urish/tt07-charge-pump/sim/freq_voltage_plot.png

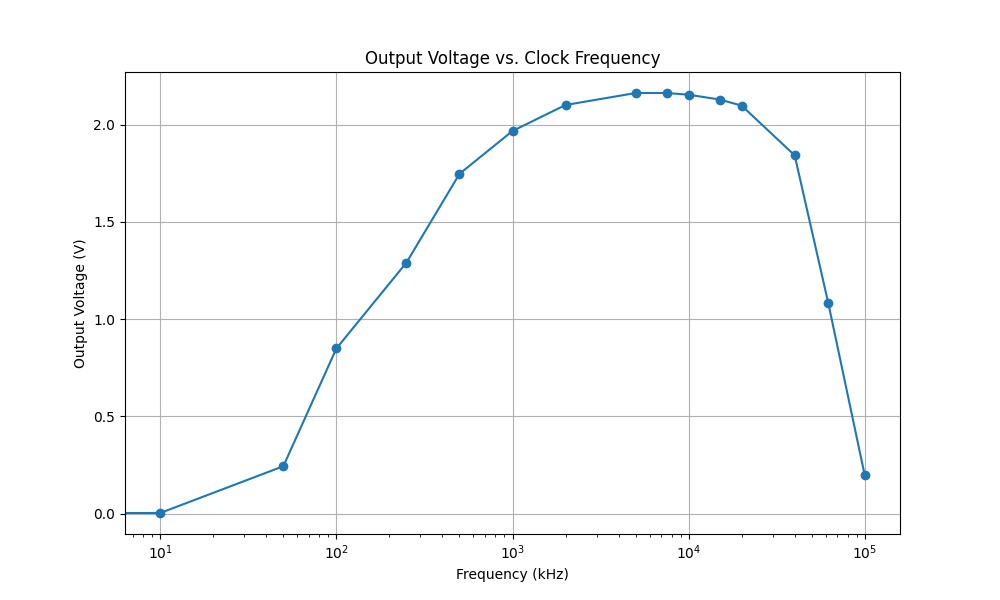
sim/freq_voltage_plot.png
