urish/tt07-charge-pump/sim/tt_um_urish_charge_pump.spice

* NGSPICE file created from tt_um_urish_charge_pump.ext - technology: sky130A

.subckt tt_um_urish_charge_pump clk ena rst_n ua[0] ua[1] ua[2] ua[3] ua[4] ua[5]
+ ua[6] ua[7] ui_in[0] ui_in[1] ui_in[2] ui_in[3] ui_in[4] ui_in[5] ui_in[6] ui_in[7]
+ uio_in[0] uio_in[1] uio_in[2] uio_in[3] uio_in[4] uio_in[5] uio_in[6] uio_in[7]
+ uio_oe[0] uio_oe[1] uio_oe[2] uio_oe[3] uio_oe[4] uio_oe[5] uio_oe[6] uio_oe[7]
+ uio_out[0] uio_out[1] uio_out[2] uio_out[3] uio_out[4] uio_out[5] uio_out[6] uio_out[7]
+ uo_out[0] uo_out[1] uo_out[2] uo_out[3] uo_out[4] uo_out[5] uo_out[6] uo_out[7]
+ VPWR VGND
X0 clka clk.t0 VGND.t2 VGND.t0 sky130_fd_pr__nfet_01v8 ad=0.29 pd=2.58 as=0.29 ps=2.58 w=1 l=0.45
X1 stage2.t4 clkb.t0 sky130_fd_pr__cap_mim_m3_1 l=25 w=25
X2 ua[0].t3 VGND.t3 VGND.t4 ua[0].t2 sky130_fd_pr__pfet_g5v0d10v5 ad=0.1218 pd=1.42 as=0.1218 ps=1.42 w=0.42 l=40
X3 stage3.t0 stage2.t0 stage2.t2 stage2.t1 sky130_fd_pr__nfet_01v8_lvt ad=2.03 pd=14.58 as=2.03 ps=14.58 w=7 l=8
X4 VGND.t5 vout sky130_fd_pr__cap_mim_m3_1 l=25 w=30
X5 stage3.t4 clka.t1 sky130_fd_pr__cap_mim_m3_1 l=25 w=25
X6 clkb.t2 clka VGND.t1 VGND.t0 sky130_fd_pr__nfet_01v8 ad=0.29 pd=2.58 as=0.29 ps=2.58 w=1 l=0.45
X7 VPWR.t2 clk.t1 clka VPWR.t0 sky130_fd_pr__pfet_01v8 ad=0.435 pd=3.58 as=0.435 ps=3.58 w=1.5 l=0.45
X8 ua[0].t1 ua[0].t0 vout.t1 vout.t0 sky130_fd_pr__pfet_g5v0d10v5 ad=0.1218 pd=1.42 as=0.1218 ps=1.42 w=0.42 l=40
X9 stage3.t3 stage3.t1 vout stage3.t2 sky130_fd_pr__nfet_01v8_lvt ad=2.03 pd=14.58 as=2.03 ps=14.58 w=7 l=8
X10 stage2.t3 stage1.t0 stage1.t2 stage1.t1 sky130_fd_pr__nfet_01v8_lvt ad=2.03 pd=14.58 as=2.03 ps=14.58 w=7 l=8
X11 stage1.t3 VPWR.t3 VPWR.t5 VPWR.t4 sky130_fd_pr__nfet_01v8_lvt ad=2.03 pd=14.58 as=2.03 ps=14.58 w=7 l=8
X12 stage1.t4 clka.t0 sky130_fd_pr__cap_mim_m3_1 l=25 w=25
X13 VPWR.t1 clka.t2 clkb.t1 VPWR.t0 sky130_fd_pr__pfet_01v8 ad=0.435 pd=3.58 as=0.435 ps=3.58 w=1.5 l=0.45
R0 clk.n0 clk.t1 276.433
R1 clk.n0 clk.t0 244.831
R2 clk clk.n0 12.3379
R3 VGND.n7 VGND.n3 2479.88
R4 VGND.n7 VGND.n4 2479.88
R5 VGND.n19 VGND.n3 2479.88
R6 VGND.n19 VGND.n4 2479.88
R7 VGND.n18 VGND.n12 2479.88
R8 VGND.n12 VGND.n8 2479.88
R9 VGND.n10 VGND.n8 2479.88
R10 VGND.n18 VGND.n10 2479.88
R11 VGND.n51 VGND.t4 660.787
R12 VGND.n9 VGND.n5 403.712
R13 VGND.n11 VGND.n5 403.712
R14 VGND.n20 VGND.n19 195
R15 VGND.n19 VGND.t0 195
R16 VGND.n7 VGND.n6 195
R17 VGND.t0 VGND.n7 195
R18 VGND.n18 VGND.n17 195
R19 VGND.t0 VGND.n18 195
R20 VGND.n14 VGND.n8 195
R21 VGND.t0 VGND.n8 195
R22 VGND.n6 VGND.n2 161.13
R23 VGND.n6 VGND.n1 161.13
R24 VGND.n20 VGND.n2 161.13
R25 VGND.n17 VGND.n13 161.13
R26 VGND.n14 VGND.n13 161.13
R27 VGND.n15 VGND.n14 161.13
R28 VGND.n21 VGND.n20 153.601
R29 VGND.n17 VGND.n16 139.294
R30 VGND.n4 VGND.n1 117.001
R31 VGND.n11 VGND.n4 117.001
R32 VGND.n3 VGND.n2 117.001
R33 VGND.n9 VGND.n3 117.001
R34 VGND.n13 VGND.n10 117.001
R35 VGND.n10 VGND.n9 117.001
R36 VGND.n15 VGND.n12 117.001
R37 VGND.n12 VGND.n11 117.001
R38 VGND.n0 VGND.t1 84.0308
R39 VGND.n22 VGND.t2 83.9547
R40 VGND.n52 VGND.n51 26.0302
R41 VGND.n16 VGND.n15 21.8358
R42 VGND.n22 VGND.n21 9.3005
R43 VGND.n16 VGND.n0 9.3005
R44 VGND.n21 VGND.n1 7.52991
R45 VGND.n51 VGND.t3 7.28674
R46 VGND.t0 VGND.n5 5.98486
R47 VGND.n23 VGND.n0 5.60682
R48 VGND.n23 VGND.n22 5.50342
R49 VGND.n49 VGND 4.20543
R50 VGND.n53 VGND.n52 3.8545
R51 VGND.n49 VGND.n48 2.61057
R52 VGND.n24 VGND.n23 2.23174
R53 VGND.n35 uio_oe[7] 1.43262
R54 VGND.n36 VGND.n35 0.438736
R55 VGND VGND.n53 0.365382
R56 VGND.n47 VGND.n46 0.342995
R57 VGND.n46 VGND.n45 0.342995
R58 VGND.n45 VGND.n44 0.342995
R59 VGND.n44 VGND.n43 0.342995
R60 VGND.n43 VGND.n42 0.342995
R61 VGND.n42 VGND.n41 0.342995
R62 VGND.n41 VGND.n40 0.342995
R63 VGND.n40 VGND.n39 0.342995
R64 VGND.n39 VGND.n38 0.342995
R65 VGND.n38 VGND.n37 0.342995
R66 VGND.n37 VGND.n36 0.342995
R67 VGND.n47 uio_out[3] 0.118783
R68 VGND.n46 uio_out[4] 0.118783
R69 VGND.n45 uio_out[5] 0.118783
R70 VGND.n44 uio_out[6] 0.118783
R71 VGND.n43 uio_out[7] 0.118783
R72 VGND.n42 uio_oe[0] 0.118783
R73 VGND.n41 uio_oe[1] 0.118783
R74 VGND.n40 uio_oe[2] 0.118783
R75 VGND.n39 uio_oe[3] 0.118783
R76 VGND.n38 uio_oe[4] 0.118783
R77 VGND.n37 uio_oe[5] 0.118783
R78 VGND.n36 uio_oe[6] 0.118783
R79 VGND.n24 uo_out[0] 0.118783
R80 VGND.n25 uo_out[1] 0.118783
R81 VGND.n26 uo_out[2] 0.118783
R82 VGND.n27 uo_out[3] 0.118783
R83 VGND.n28 uo_out[4] 0.118783
R84 VGND.n29 uo_out[5] 0.118783
R85 VGND.n30 uo_out[6] 0.118783
R86 VGND.n31 uo_out[7] 0.118783
R87 VGND.n32 uio_out[0] 0.118783
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
C246 stage2.n3 VGND 1.11561f
C247 stage2.n4 VGND 0.076546f
C248 stage2.n5 VGND 1.33824f
C249 stage2.n6 VGND 0.076462f
C250 stage2.n7 VGND 1.36594f
C251 stage2.n8 VGND 0.058842f
C252 clka.t2 VGND 0.080865f
C253 clka.t1 VGND 60.1965f
C254 clka.t0 VGND 58.862103f
C255 clka.n0 VGND 2.94109f
.ends
