urish/tt07-charge-pump/(commit log)

2024-06-01 chore: update for TT07
    1. Update github actions tag
    2. Update .def template
    3. Change ua pins widths (600 um → 900 um)
2024-06-01 feat: higher output voltage
    divide the output voltage by 2 instead of 6, so now we expect ~2.5V on the ua[0] pin.
    [dickson.sch]
2025-05-12 feat(sim): script to measure output voltage at different clock frequencies
